NicolAlex/2026_ME-301_group_43_KuDAQ/data_analysis/note.txt

50_01 --> 0.0548 Hz / 2920 dB
50_02 --> 0.0494 Hz / 2884 dB
50_03 --> 0.0395 Hz / 2713 dB

25mm, 45 minute bundle :
3 spikes :
0.127 Hz / 5229 dB
0.131 Hz / 5231 dB
0.135 Hz / 5366 dB
