NicolAlex/2026_ME-301_group_43_KuDAQ/report/IMG_1316.jpg

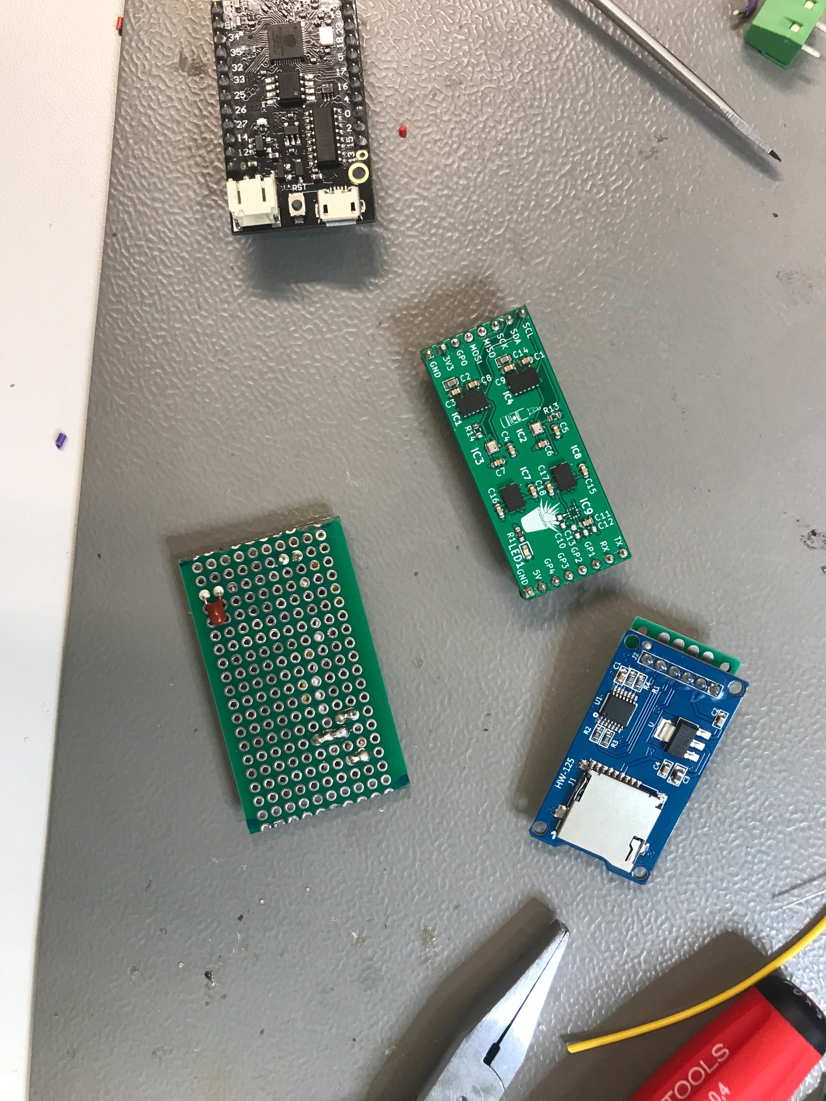
report/IMG_1316.jpg
