NicolAlex/2026_ME-301_group_43_KuDAQ/(commit log)

2026-03-18 made the sensor class
2026-03-21 multithreading working, sensor class completed
2026-04-06 Orientation filter added and working, 3d animation added
